conejoninja/keyboards/confnicebadge/build/build.md

# conf2025badge

conf2025badge のビルドガイドです。  

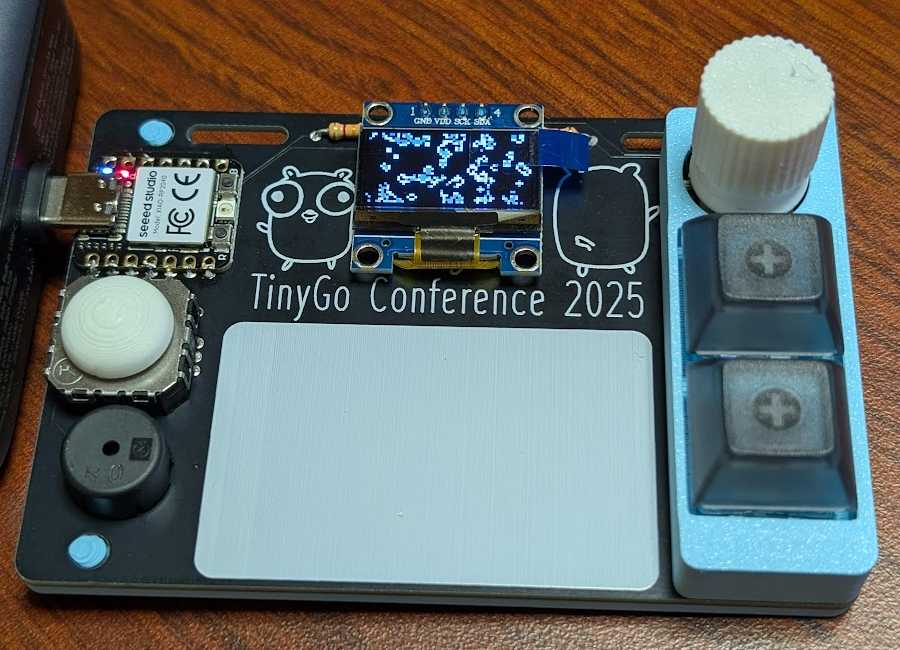
[picture p1: confnicebadge/build/images/24.jpg]


回路及びケースデータは以下。  
※回路データはブザーの位置が少しずれているので要修正  

* [kicanvas](https://kicanvas.org/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)
* [case (stl / 3mf)](./conf2025badge/stl/)

TinyGo で動かすためのワークショップ資料は以下。  

* [github.com/tinygo-keeb/workshop-conf2025badge](https://github.com/tinygo-keeb/workshop-conf2025badge)

## パーツ一覧

必要なパーツは以下の通り。  

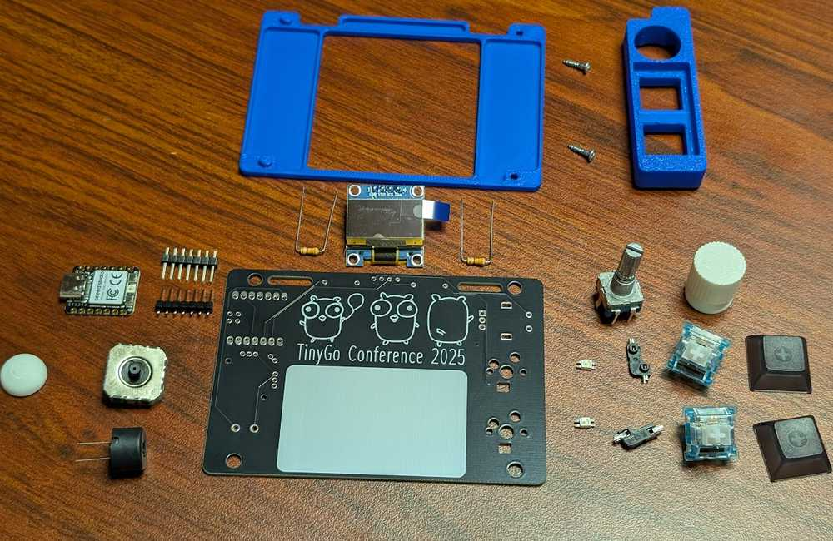
[picture p2: confnicebadge/build/images/01.jpg]


| No | 品名 | 個数 | 備考 |
|---|---|---|---|
| 1 | 基板 | 1 | |
| 2 | [XIAO RP2040](https://akizukidenshi.com/catalog/g/g117044/) | 1 | |
| 3 | [ジョイスティック](https://akizukidenshi.com/catalog/g/g104048/) | 1 | |
| 4 | [OLED 液晶](https://akizukidenshi.com/catalog/g/g112031/) | 1 | SSD1306 128x64 |
| 5 | [プルアップ抵抗](https://akizukidenshi.com/catalog/g/g116332/) | 2 | 3.3K (1K – 10K) |
| 6 | [キースイッチ](https://shop.yushakobo.jp/collections/all-switches) | 2 | |
| 7 | [キーキャップ](https://shop.yushakobo.jp/collections/keycaps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) | 2 | |
| 8 | [キーソケット](https://shop.yushakobo.jp/products/a01ps?variant=37665172521121) | 2 | MX socket |
| 9 | ロータリーエンコーダー | 1 | EC11 互換、20mm Plum |
| 10 | [RGB LED](https://akizukidenshi.com/catalog/g/g115478/) | 2 | SK6812MINI-E |
| 11 | [ブザー](https://akizukidenshi.com/catalog/g/g104118/) | 1 | |
| 12 | エンコーダーノブ | 1 | |
| 13 | ハット | 1 | ジョイスティック用 |
| 14 | スイッチプレート | 1 | |
| 15 | ボトムプレート | 1 | |
| 16 | 木ねじ 2.1×10 | 2 | |

## 作業準備

まずは以下の作業台を用意します。  
作業台がない場合は、何らかの台などで基板を固定してください。  
以下の写真のように名前を書くスペース (中央下段の大きな白塗り部分) があるのが表です。  

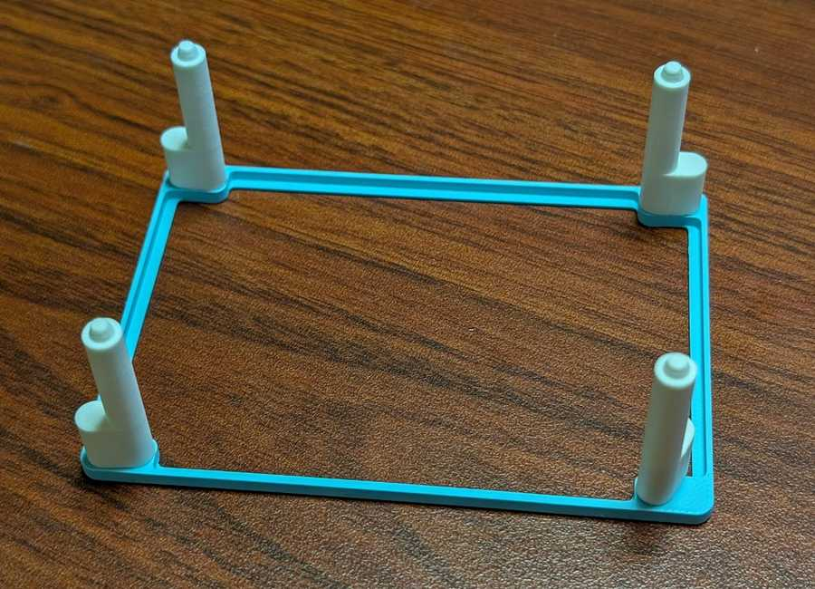
[picture p3: confnicebadge/build/images/02.jpg]

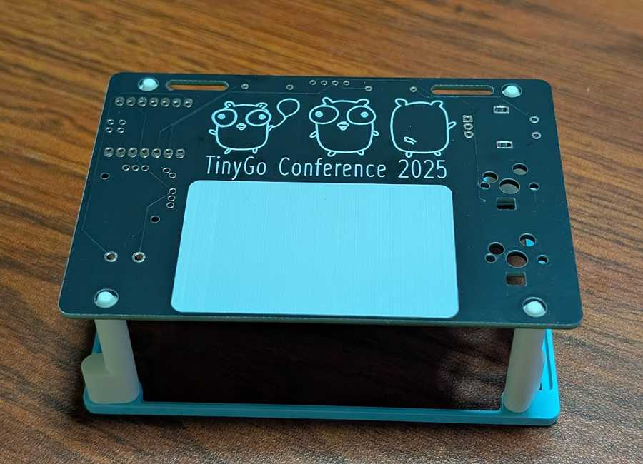
[picture p4: confnicebadge/build/images/03.jpg]


## 抵抗 x 2

まずは抵抗から。  
極性はないので刺さるように表面から刺してください。  
最終的に見える位置なので向きが気になる場合はうまく調整してください。  

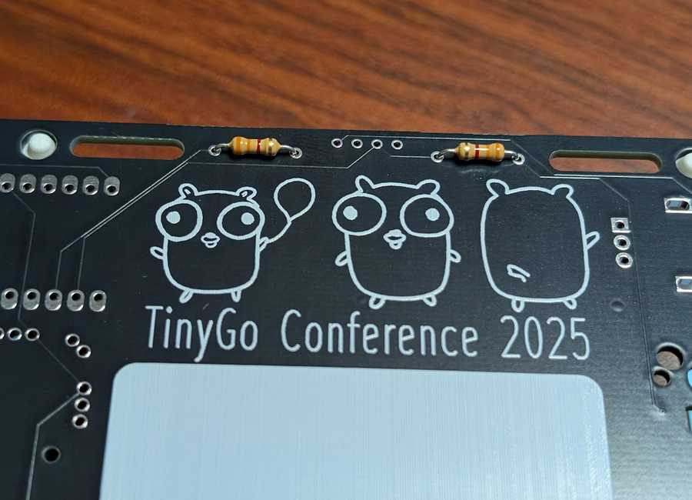
[picture p5: confnicebadge/build/images/04.jpg]


裏返して裏面からはんだ付けしていきます。  
最初に片方の抵抗の片方のピンだけはんだ付けしてください。  
その後、位置を十分に確認して、気になるところがあれば修正してください。  
修正がよくわからない場合はサポートスタッフを呼んでください。  

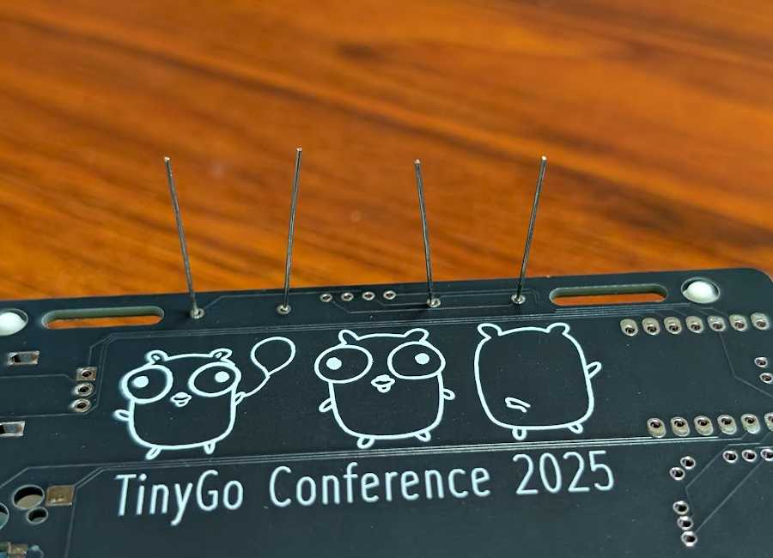
[picture p6: confnicebadge/build/images/04b.jpg]


はんだ付け完了したら足を短く (1mm 以内) にカットします。  
抵抗以外も含め、必要に応じてケースに干渉しない程度にカットしてください。  
カットするときはゴミが飛び散らないように指で押さえて実施してください。  

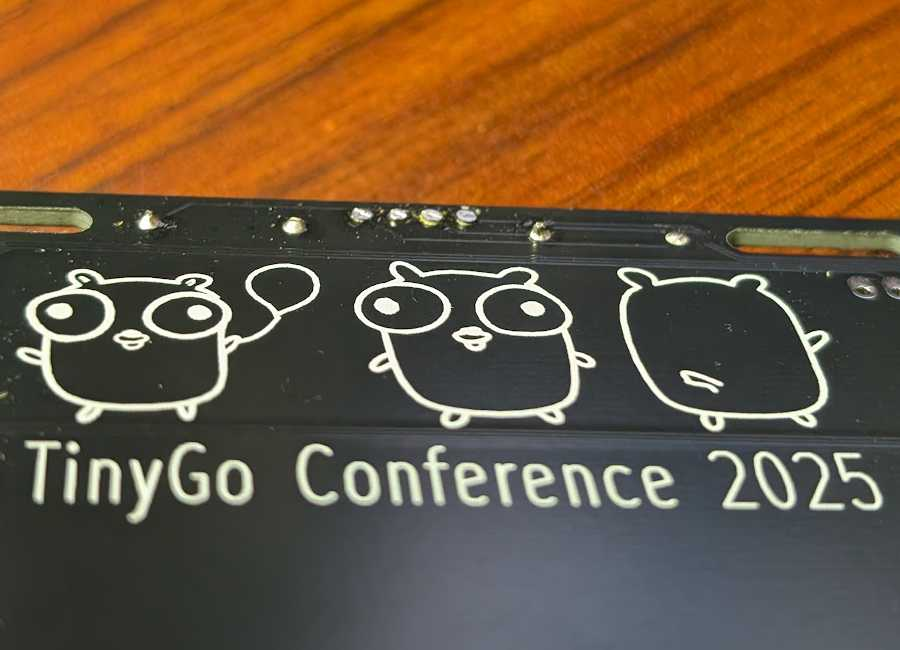
[picture p7: confnicebadge/build/images/25.jpg]


## マイコン (XIAO RP2040)

続いてマイコンをはんだ付けしていきます。  
以下の順で実施します。  

1. マイコンにピンヘッダーをはんだ付け
2. マイコンを基板にはんだ付け

まずはピンヘッダーを基板の表面に乗せてください。  
※この時点ではまだピンヘッダーははんだ付けしません  

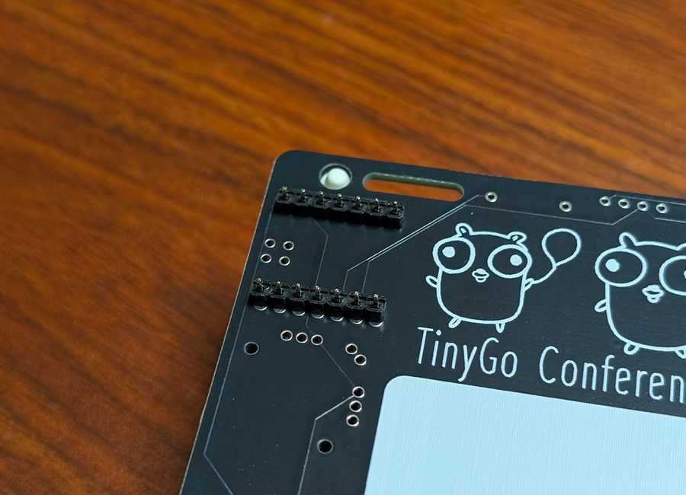
[picture p8: confnicebadge/build/images/05.jpg]


続いてそのうえにマイコンを写真の向きで載せて順番にはんだ付けします。  
ここでも 1 ピンだけはんだ付けして、位置などが問題ないかを確認し、問題があれば修正してください。  
問題なければ残りのピンをはんだ付けします。  

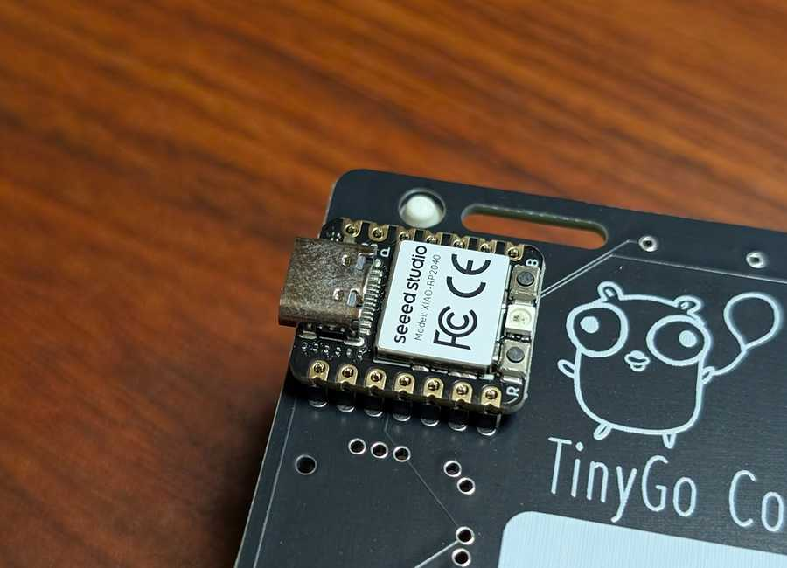
[picture p9: confnicebadge/build/images/06.jpg]


続いて裏面からはんだ付けします。  
テープでマイコンを止めて裏返します。  
はんだ付けをしていきますが、ここでも 1 ピンだけはんだ付けをして位置などを確認してください。  
問題なければ残りのピンをはんだ付けします。  

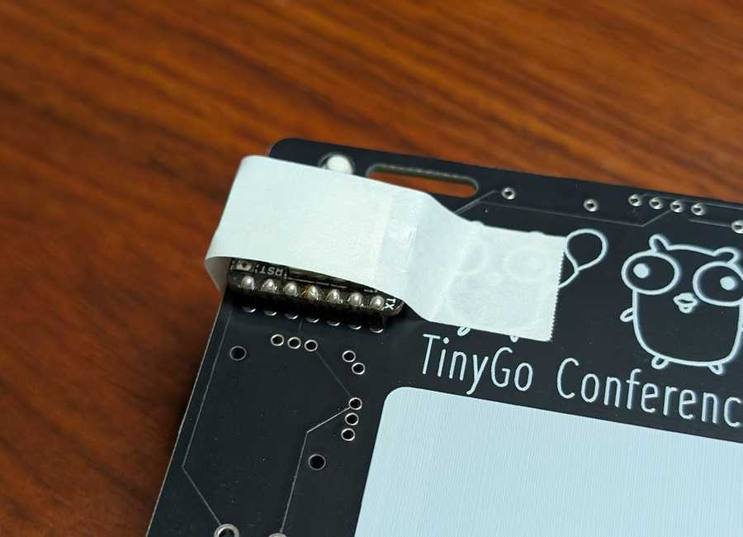
[picture p10: confnicebadge/build/images/07.jpg]

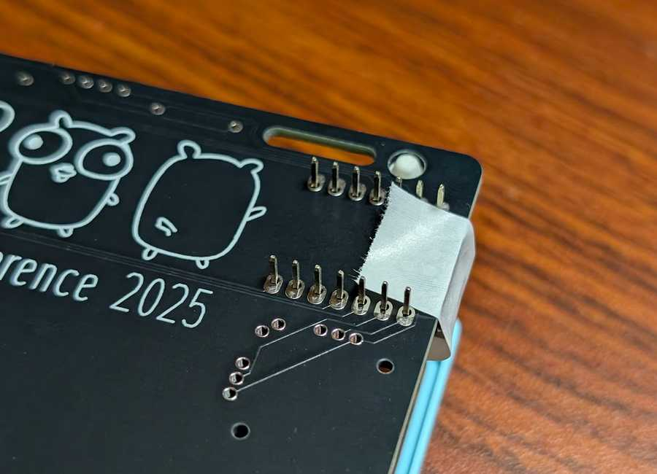
[picture p11: confnicebadge/build/images/08.jpg]


ピンヘッダーの足は短くカットする必要があります。  
割と硬いためスタッフにて切断します。  
スタッフに声をかけてください。  
自分でする場合は、切断した破片が飛んでいかないように手で押さえつつカットしてください。  

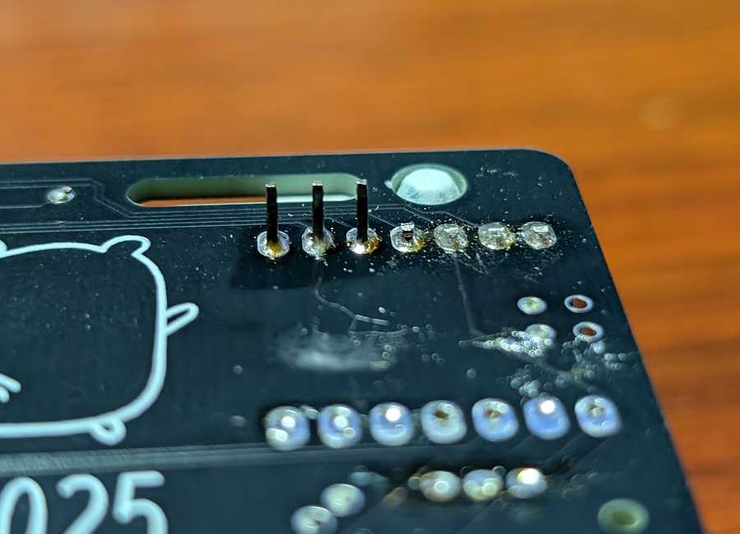
[picture p12: confnicebadge/build/images/26.jpg]


## ジョイスティック

表面にジョイスティックを置いてマスキングテープで固定します。  

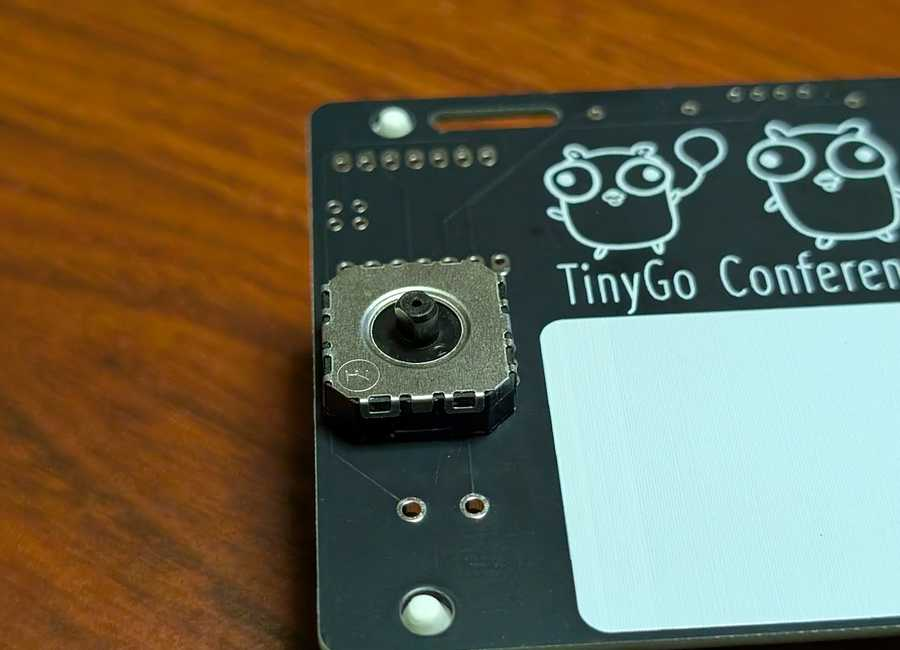
[picture p13: confnicebadge/build/images/09.jpg]


はんだ付けは裏返して裏側から行います。  
ここでも 1 ピンだけはんだ付けして、位置などが問題ないかを確認し、問題があれば修正してください。  
問題なければ残りのピンをはんだ付けします。  

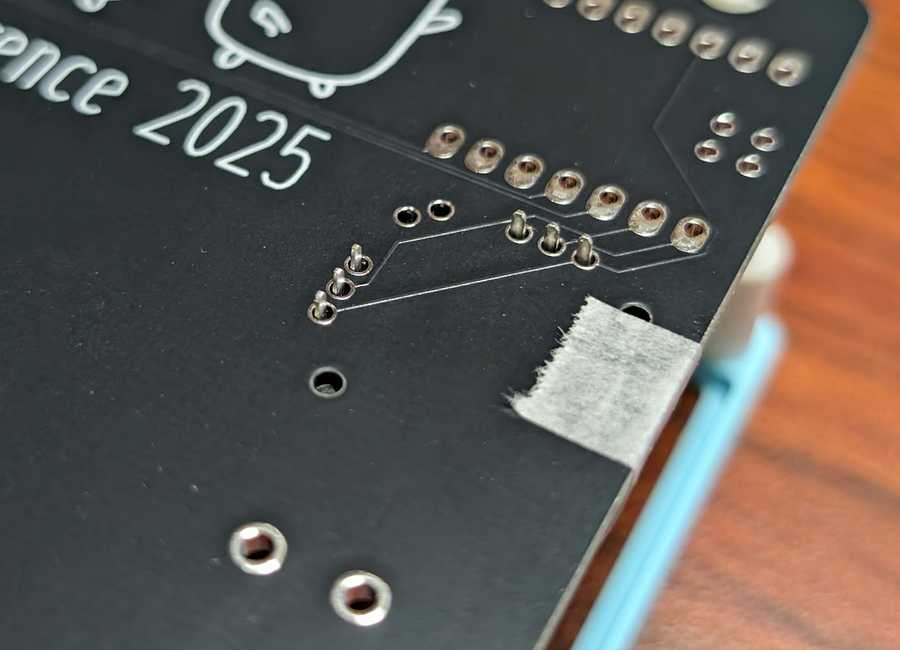
[picture p14: confnicebadge/build/images/10.jpg]


## LED (SK6812MINI-E)

表面実装の LED です。  
上級者向けなので難しそう、と思った場合はスタッフを呼んでください。  
失敗しても or 壊しても予備があるので、とりあえずトライしてみるのもよいです。  

裏面に写真の向きに置いて (このまま上にスライドして穴にセットする) はんだ付けしていきます。  
基板に印刷された△のマークと、 LED の足の切り欠きを合わせる必要があります。  
方向の間違いが多いため、はんだ付け前後いずれかでスタッフを呼んで確認してもらってください。  

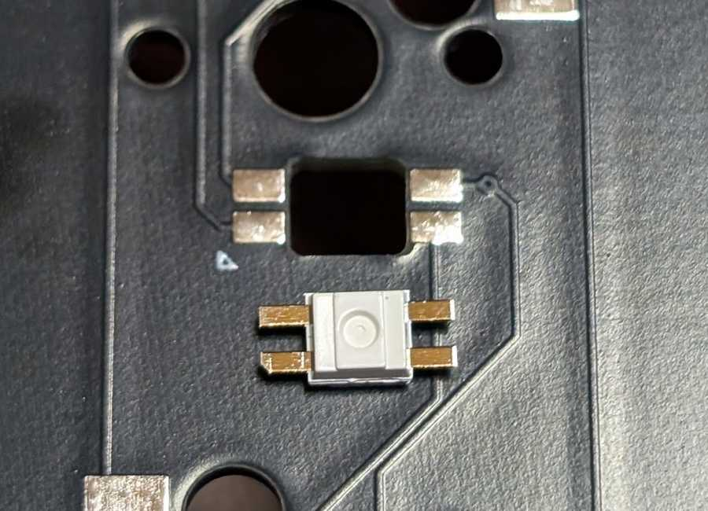
[picture p15: confnicebadge/build/images/11.jpg]


## ブザー

表面に置いてマスキングテープ、裏返して裏面からはんだ付けです。  
ここでも 1 ピンだけはんだ付けして、位置などが問題ないかを確認し、問題があれば修正してください。  
問題なければ残りのピンをはんだ付けします。  

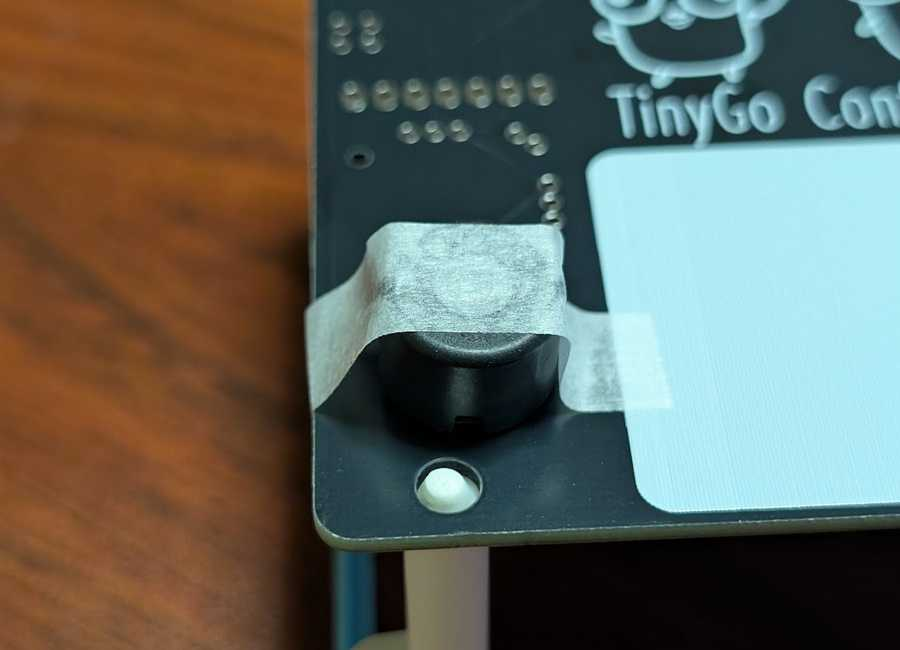
[picture p16: confnicebadge/build/images/12.jpg]

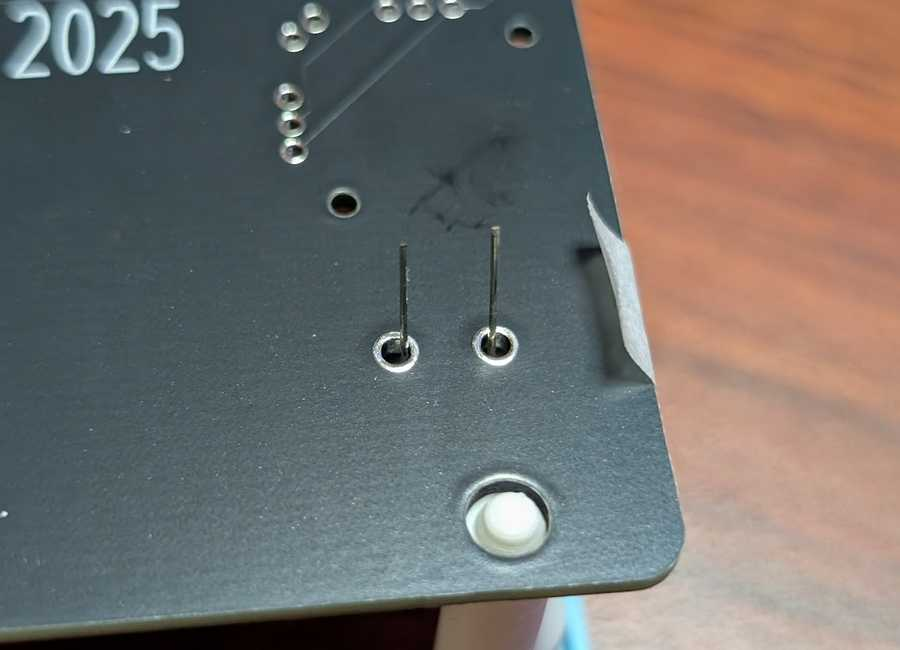
[picture p17: confnicebadge/build/images/13.jpg]


はんだ付け完了したら足を短く (1mm 以内) にカットします。  
カットするときはゴミが飛び散らないように指で押さえて実施してください。  

## キーソケット

表面実装部品です。  
しっかりと基板に密着させてはんだ付けしないと仕上がりに影響します。  
修正しやすい部分なので、後でスタッフに確認してもらってください。  

裏面にまずは片側をはんだ付けします。  
詳細なやり方は以下などを参照してください。  

* [スイッチソケットのはんだ付け方法](https://github.com/tinygo-keeb/workshop/blob/main/buildguide.md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)

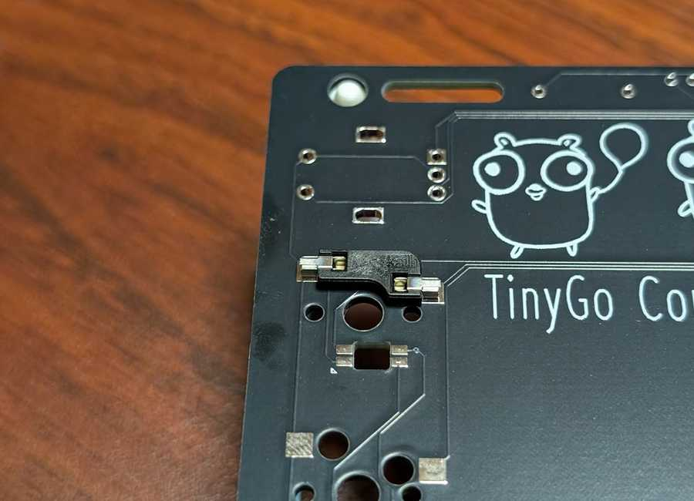
[picture p18: confnicebadge/build/images/14.jpg]


向きがあるので下の写真のようにならないよう注意してください。  

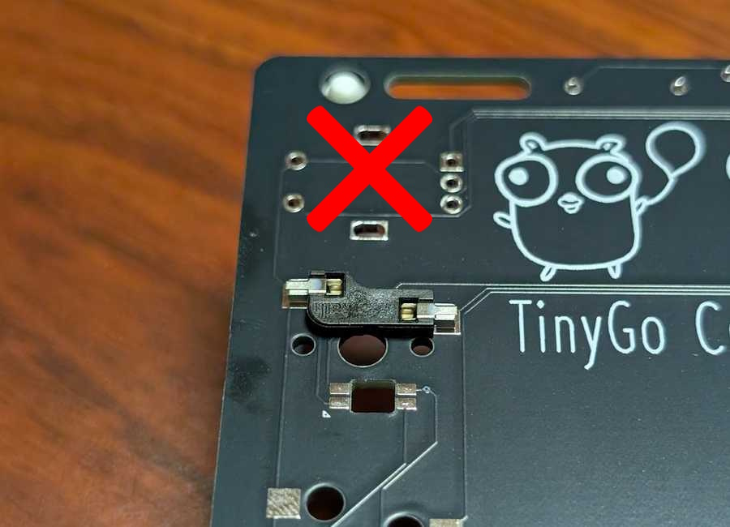
[picture p19: confnicebadge/build/images/15.jpg]


## OLED

液晶です。  
表面から刺さるように差し込み、最後まで押し込みます。  

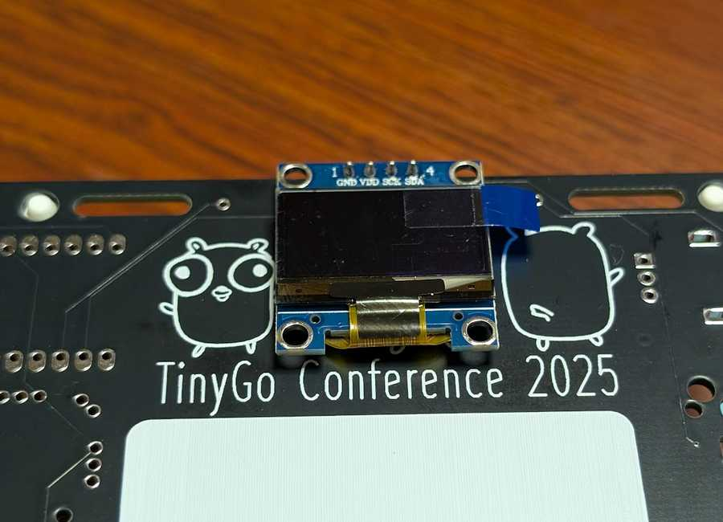
[picture p20: confnicebadge/build/images/16.jpg]


裏返して裏面からはんだ付けしていきます。  
ここでも 1 ピンだけはんだ付けして、位置などが問題ないかを確認し、問題があれば修正してください。  
問題なければ残りのピンをはんだ付けします。  

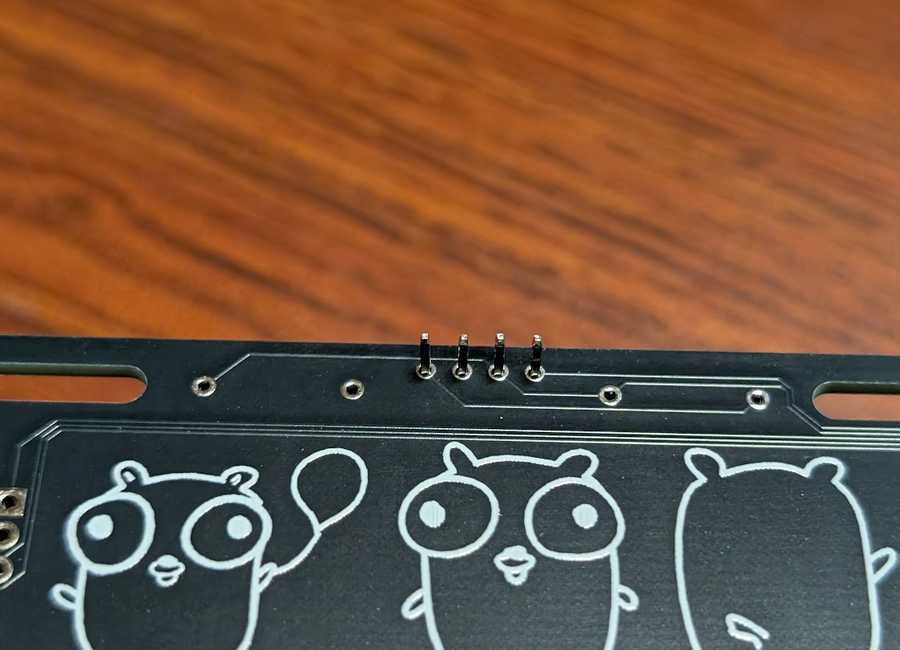
[picture p21: confnicebadge/build/images/17.jpg]


はんだ付け完了したら足を短く (1mm 以内) にカットします。  
カットするときはゴミが飛び散らないように指で押さえて実施してください。  



## ロータリーエンコーダー

表面から差し込みます。  

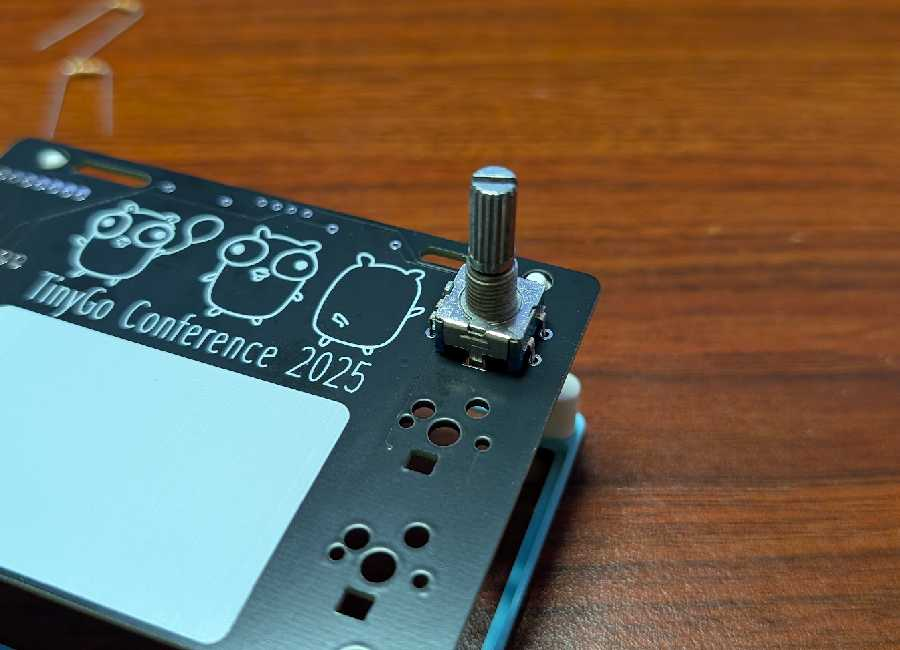
[picture p22: confnicebadge/build/images/18.jpg]


裏返して裏面からはんだ付けしていきます。  
ここでも 1 ピンだけはんだ付けして、位置などが問題ないかを確認し、問題があれば修正してください。  
問題なければ残りのピンをはんだ付けします。  

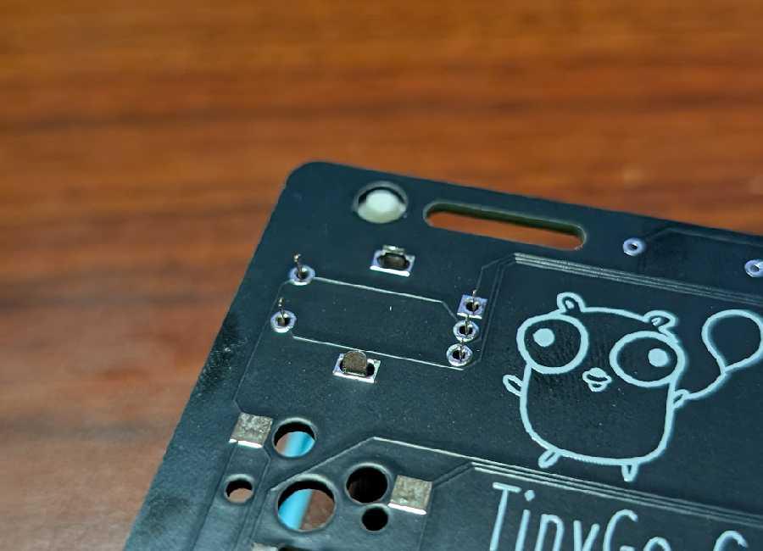
[picture p23: confnicebadge/build/images/19.jpg]


## ケース取り付け

ボトムプレート、スイッチプレートを装着します。  

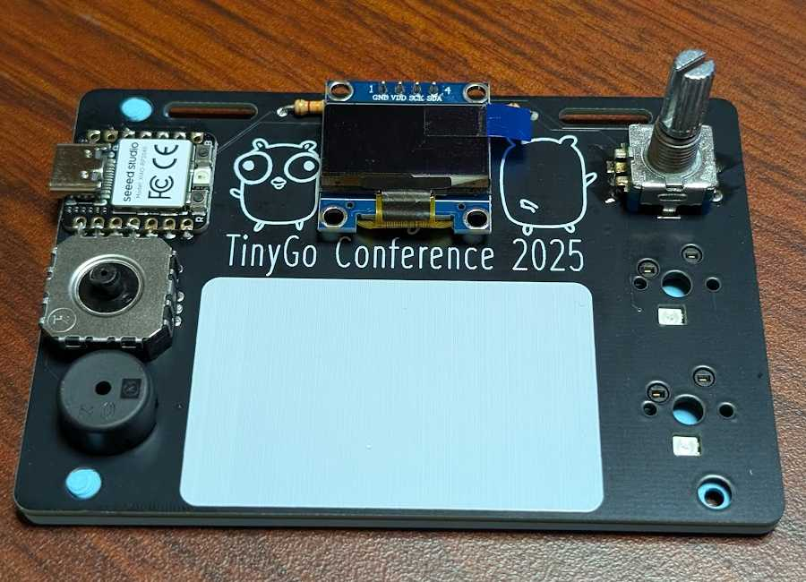
[picture p24: confnicebadge/build/images/20.jpg]

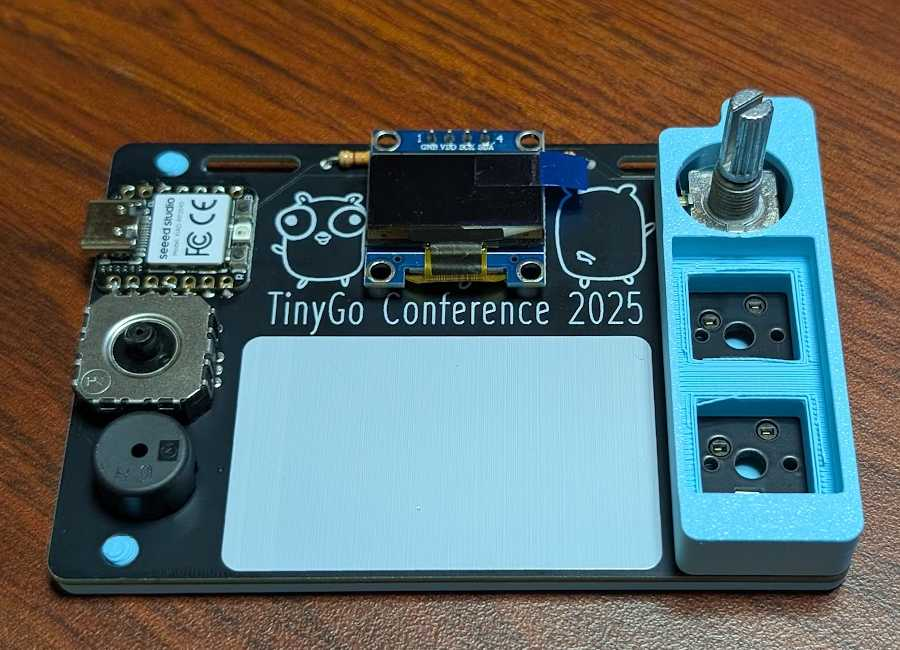
[picture p25: confnicebadge/build/images/21.jpg]


裏面からネジで止めます。  
この時、ボトムプレートを写真の右方向に軽く押し付けながらねじ止めすると、ケースのガタが減ります。  

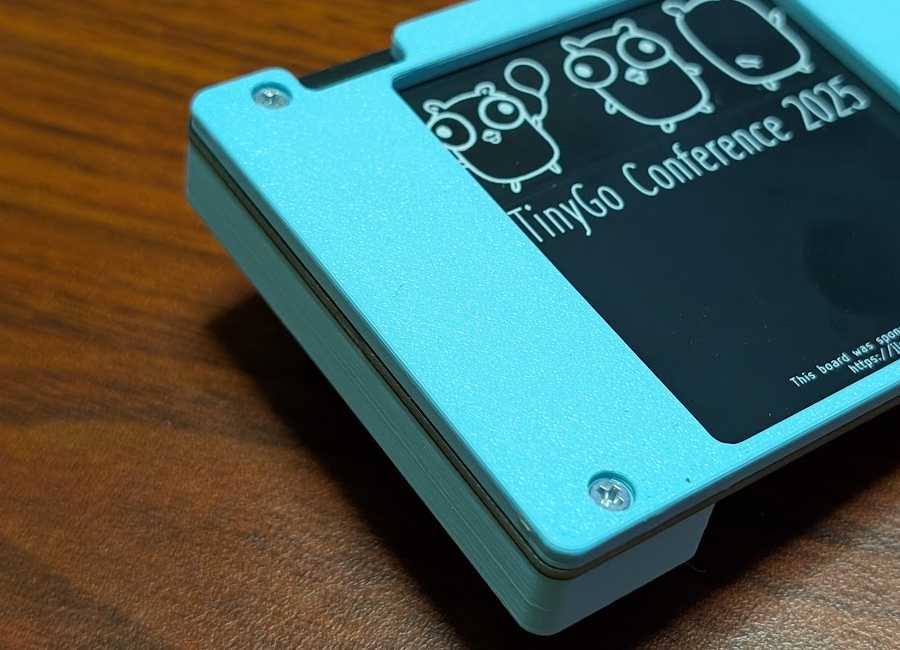
[picture p26: confnicebadge/build/images/22.jpg]


あとはロータリーエンコーダーのノブと、ジョイスティックのハットを着けたら完成です。  

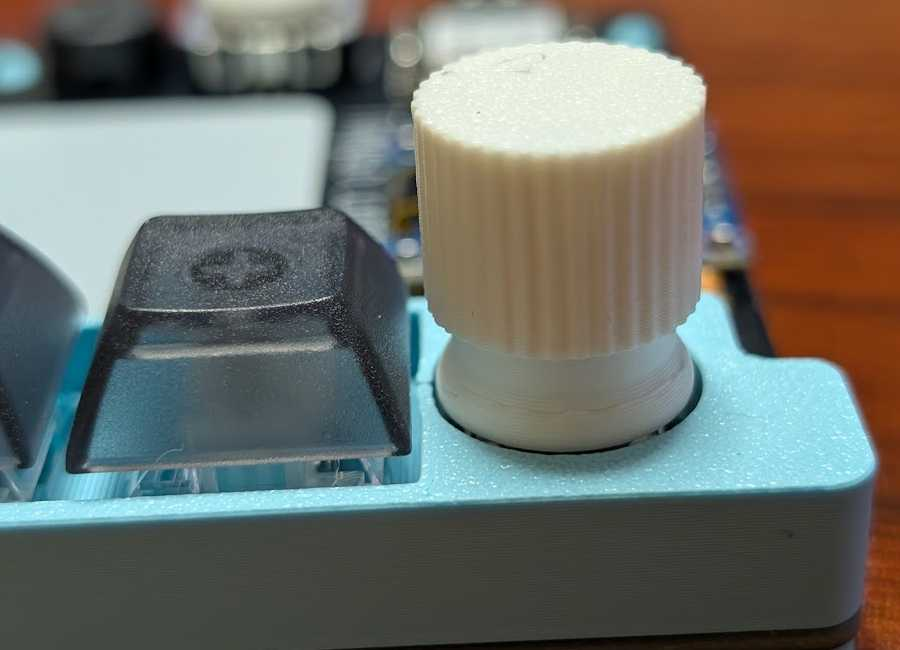
[picture p27: confnicebadge/build/images/23.jpg]


## 完成

お疲れ様でした。  
