conejoninja/keyboards/confnicebadge/stl/confnicebadge.3mf

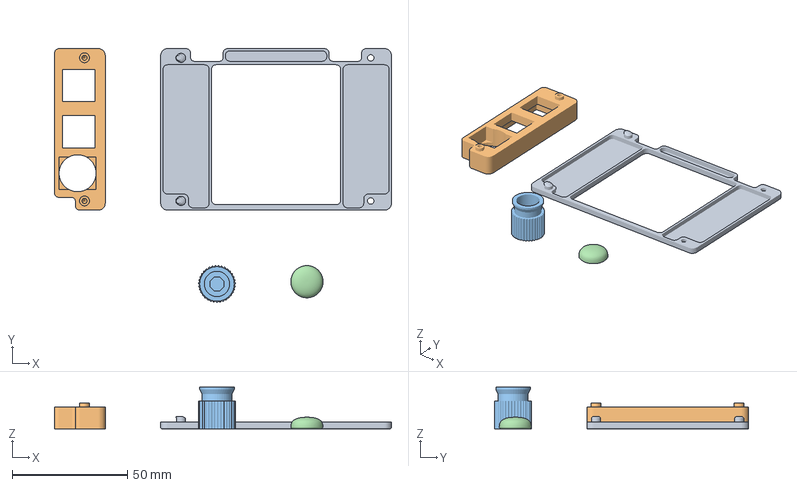
[picture p28: CAD file, 2026-02-26]
confnicebadge/stl/confnicebadge.3mf
146.0 x 110.0 x 18.0 mm
conf2025badge bottom
conf2025badge switch plate
knob small
hat
