conejoninja/keyboards/(list of files, cad)

Other CAD files:
confnicebadge/stl/confnicebadge.stl
