conejoninja/keyboards/confnicebadge/confnicebadge/confnicebadge.kicad_pcb

## KiCad design confnicebadge/confnicebadge/confnicebadge.kicad_pcb (2026-02-26)

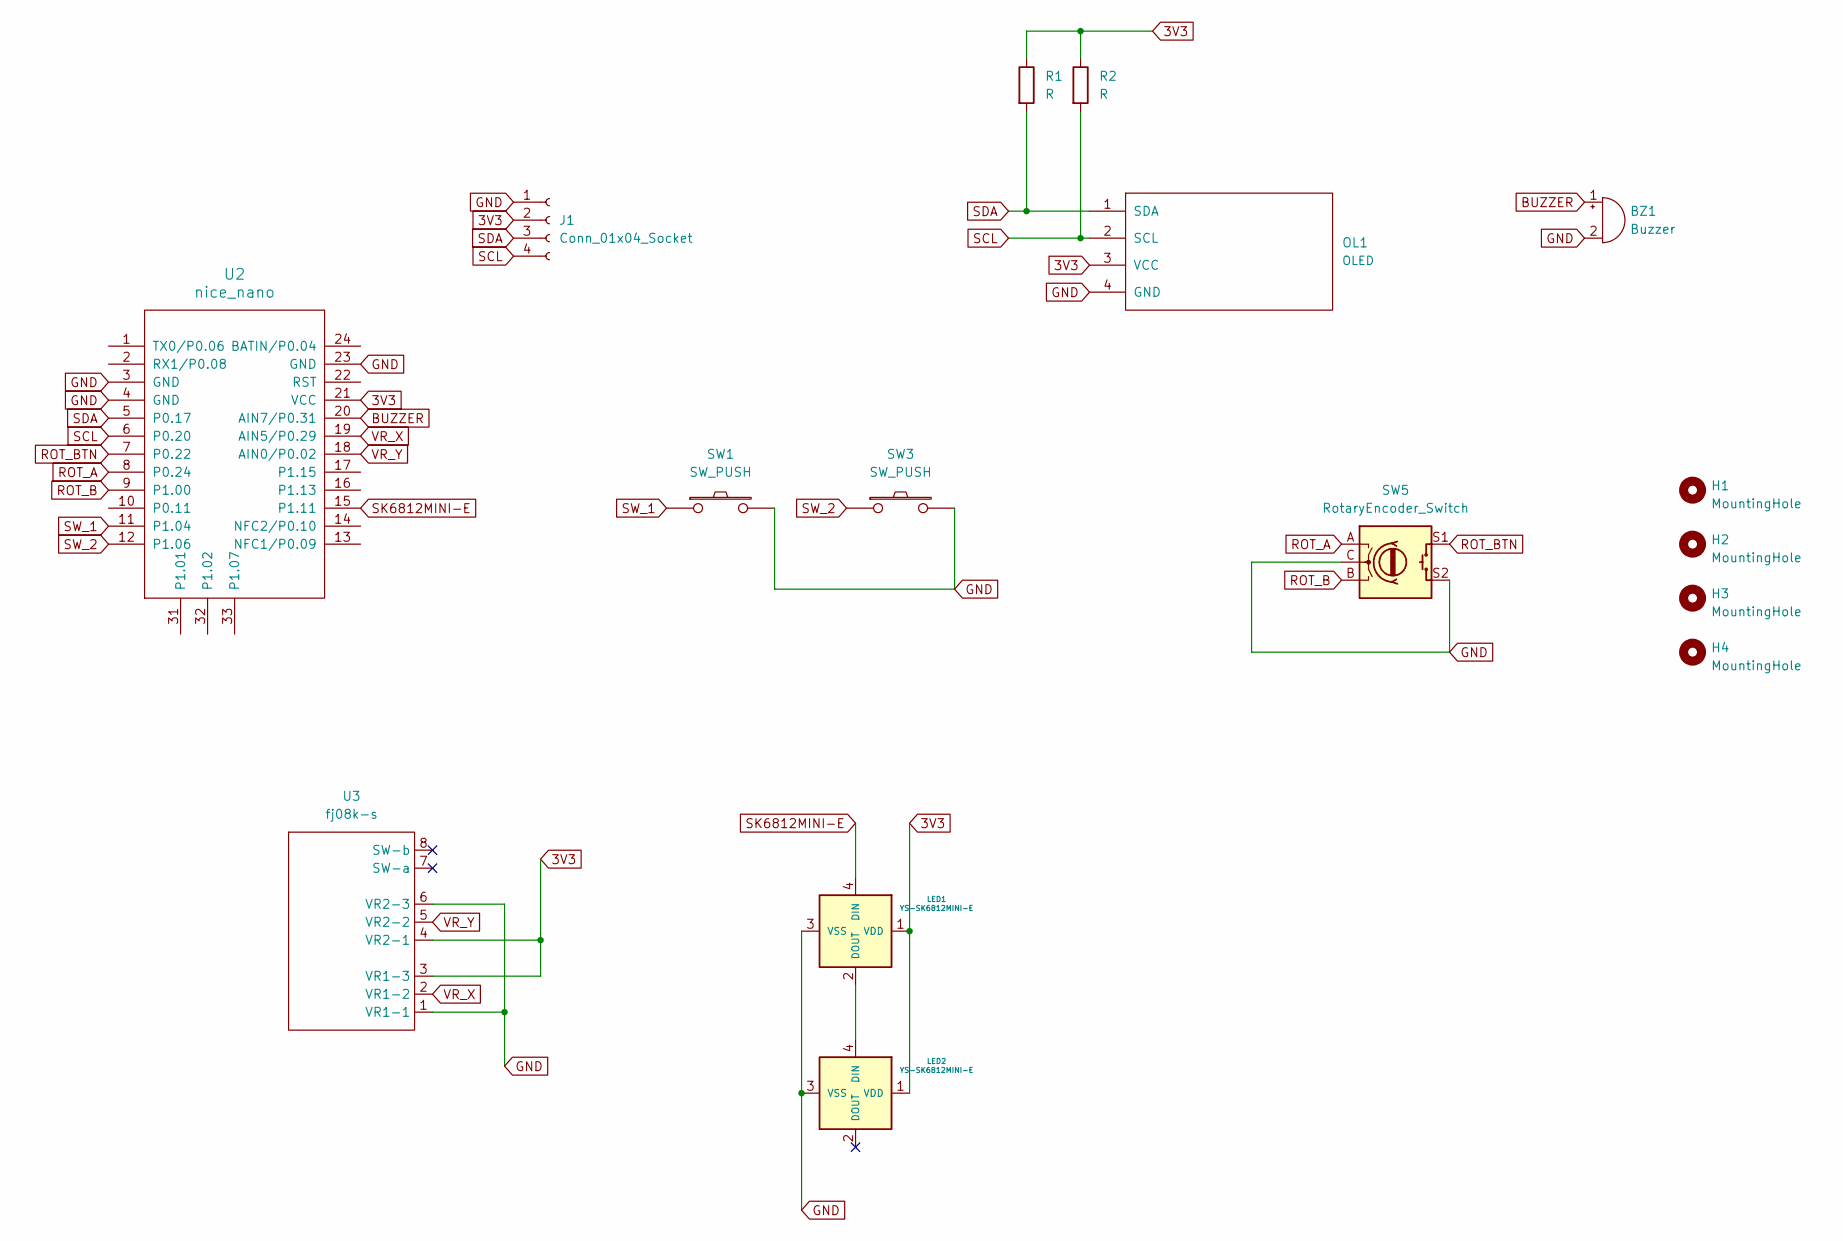
[picture p29: schematic confnicebadge.kicad_sch]

Parts:
BZ1: Buzzer; buzzer 5.5mm
H1, H2, H3, H4: MountingHole; M2_HOLE_v2
J1: Conn_01x04_Socket; PinHeader_1x04_P2.54mm_Vertical
LED1, LED2: YS-SK6812MINI-E
OL1: OLED
R1, R2: R; R_Axial_DIN0207_L6.3mm_D2.5mm_P10.16mm_Horizontal
SW1, SW3: SW_PUSH; CherryMX_Hotswap
SW5: RotaryEncoder_Switch; RotaryEncoder_Alps_EC11E-Switch_Vertical_H20mm
U2: nice_nano
U3: fj08k-s; FJ08K-S

Connections:
3V3: J1.2, LED1.1 (VDD), LED2.1 (VDD), OL1.3 (VCC), R1.1, R2.1, U2.21 (VCC), U3.3 (VR1-3), U3.4 (VR2-1)
BUZZER: BZ1.1 (+), U2.20 (AIN7/P0.31)
GND: BZ1.2 (-), J1.1, LED1.3 (VSS), LED2.3 (VSS), OL1.4 (GND), SW1.2, SW3.2, SW5.C, SW5.S2, U2.3 (GND), U2.4 (GND), U2.23 (GND), U3.1 (VR1-1), U3.6 (VR2-3)
unnamed: LED1.2 (DOUT), LED2.4 (DIN)
ROT_A: SW5.A, U2.8 (P0.24)
ROT_B: SW5.B, U2.9 (P1.00)
ROT_BTN: SW5.S1, U2.7 (P0.22)
SCL: J1.4, OL1.2 (SCL), R2.2, U2.6 (P0.20)
SDA: J1.3, OL1.1 (SDA), R1.2, U2.5 (P0.17)
SK6812MINI-E: LED1.4 (DIN), U2.15 (P1.11)
SW_1: SW1.1, U2.11 (P1.04)
SW_2: SW3.1, U2.12 (P1.06)
VR_X: U2.19 (AIN5/P0.29), U3.2 (VR1-2)
VR_Y: U2.18 (AIN0/P0.02), U3.5 (VR2-2)

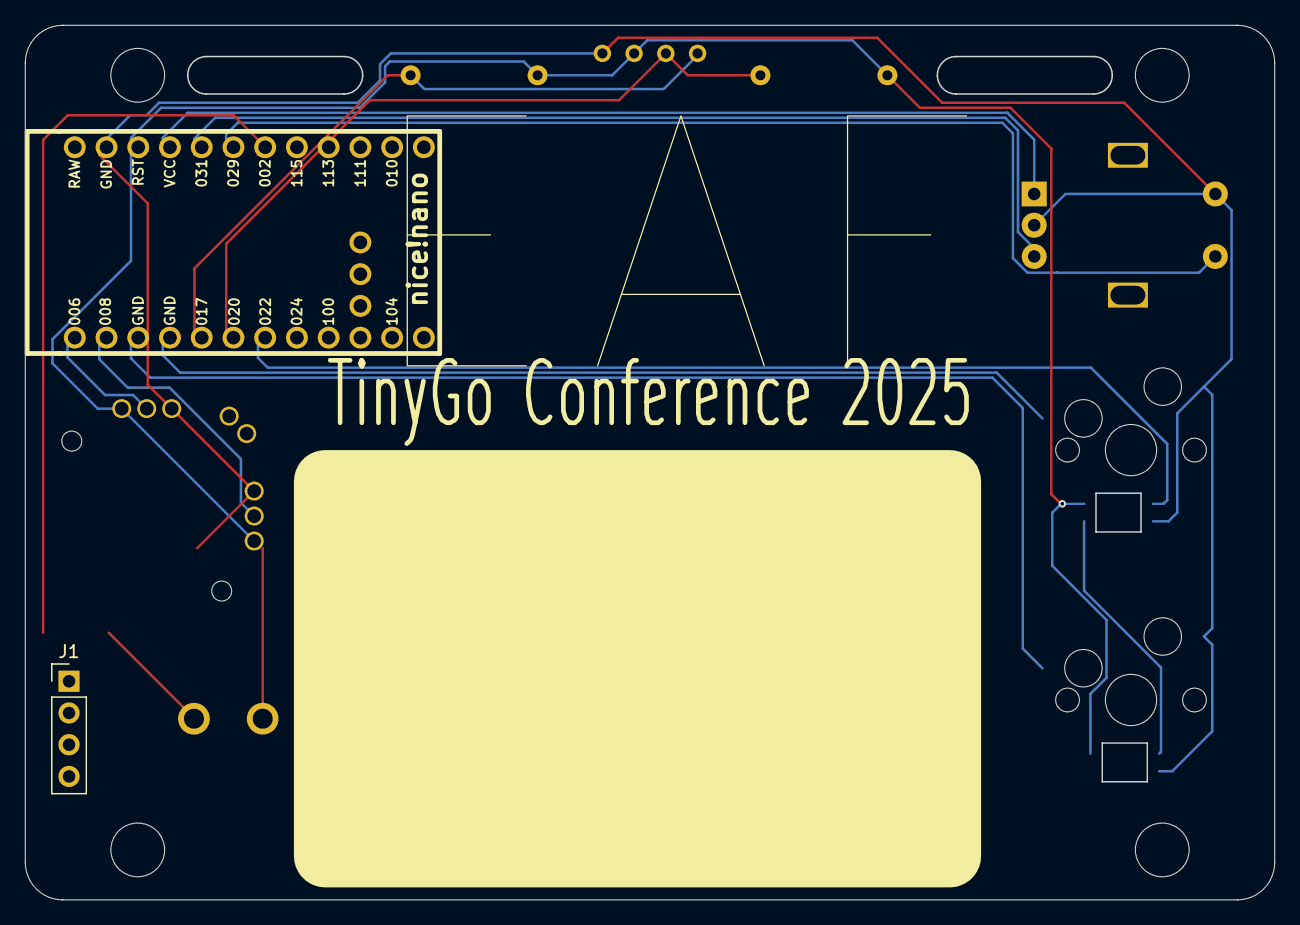
[picture p30: board confnicebadge.kicad_pcb from above]

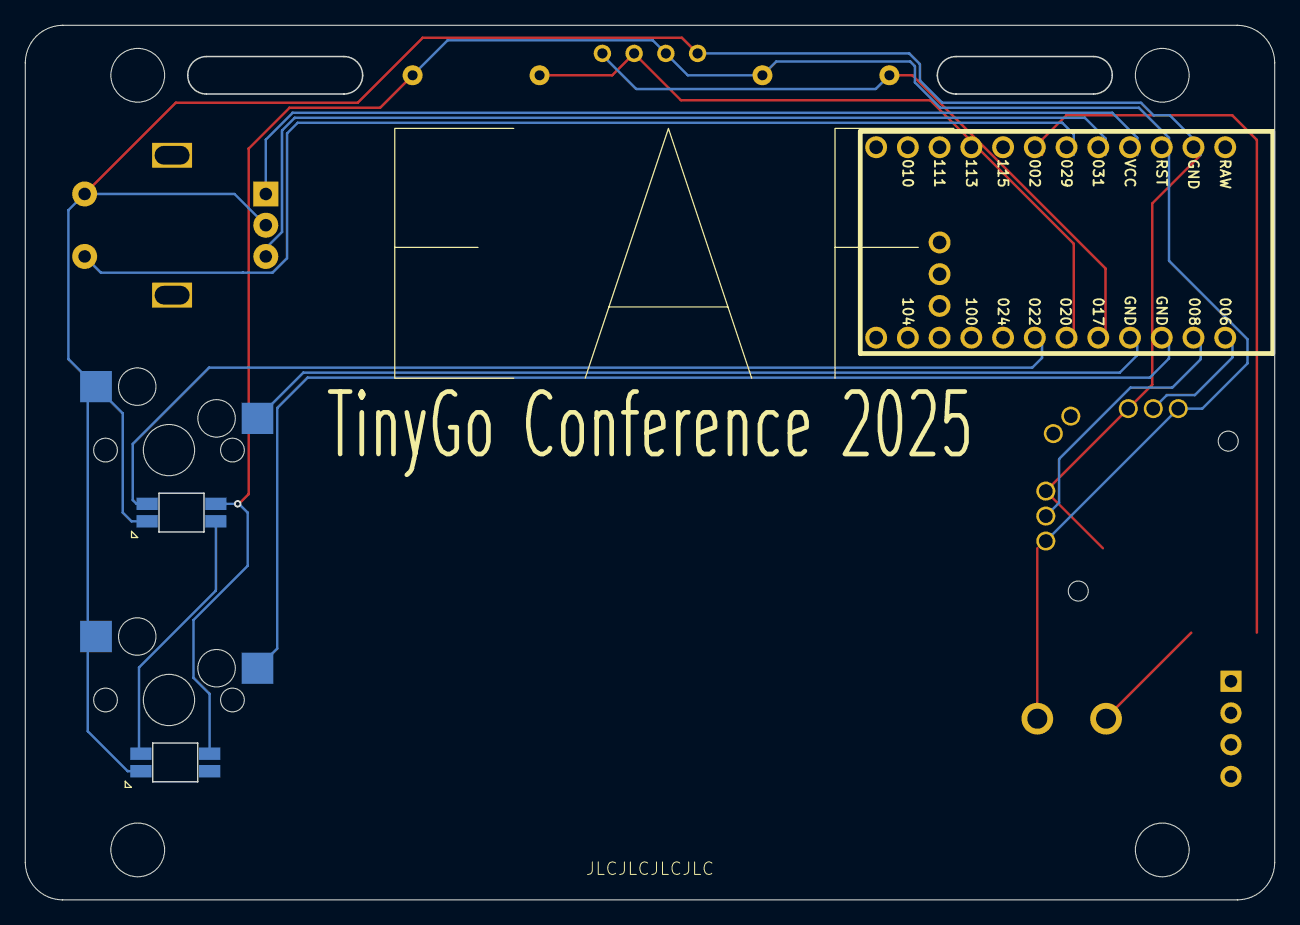
[picture p31: board confnicebadge.kicad_pcb from below]

Board: 2 copper layers, 100.0 x 70.0 mm, 18 parts (2 on the bottom side), 14 nets.

Other parts of the board:
SW2, SW2#2: KEY_SWITCH; strap_hole
